LuisFran2611/PicoFFT/img/Esquematico_FM1.png

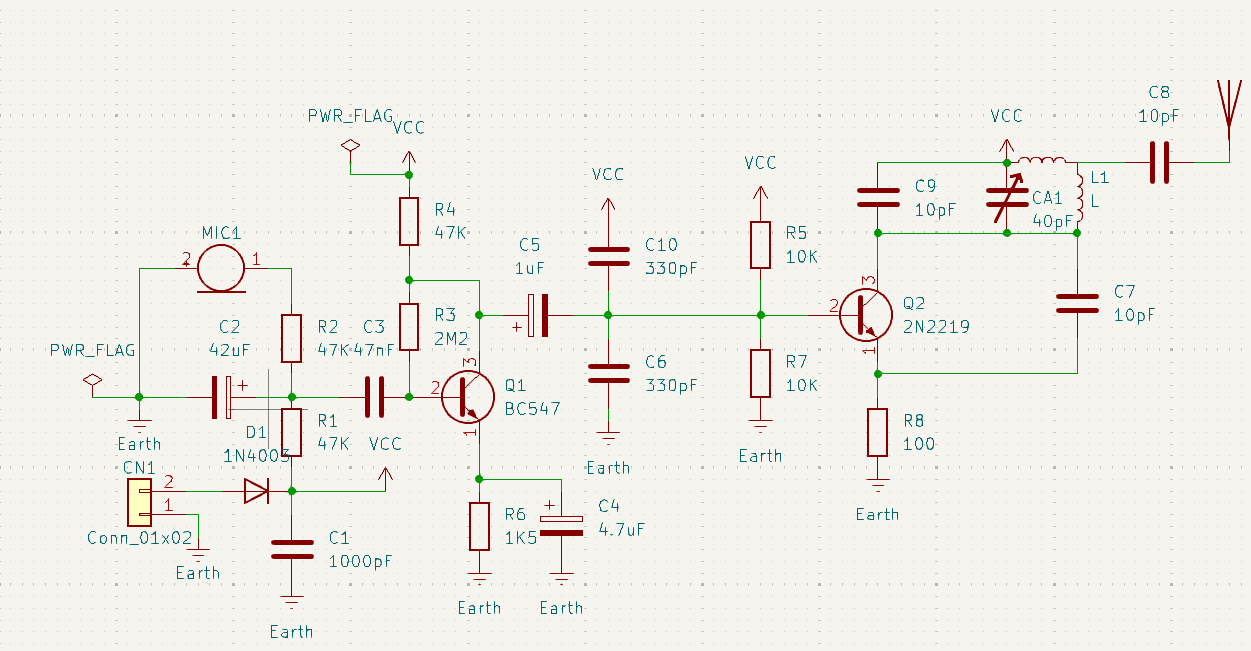
img/Esquematico_FM1.png
