LuisFran2611/PicoFFT/img/Radio.jpg

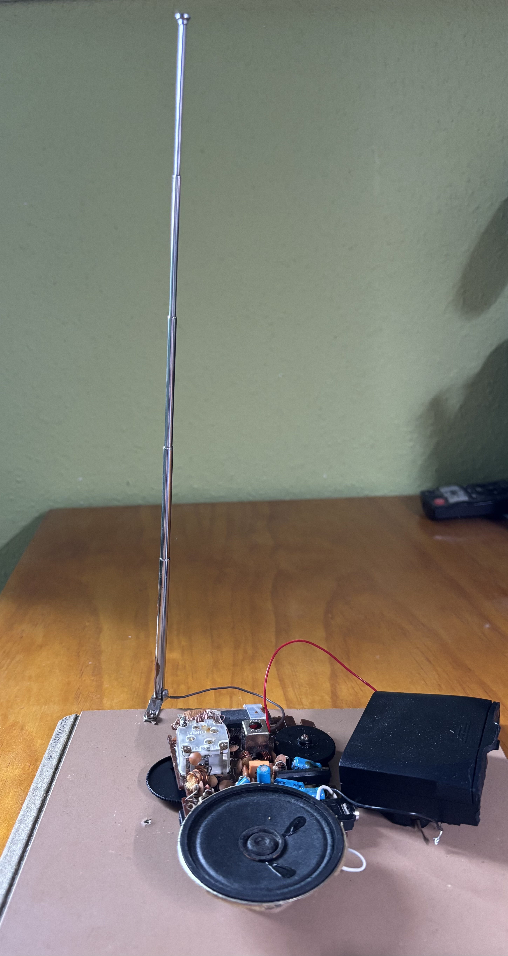
img/Radio.jpg
