LuisFran2611/PicoFFT/img/Prueba_display.JPG

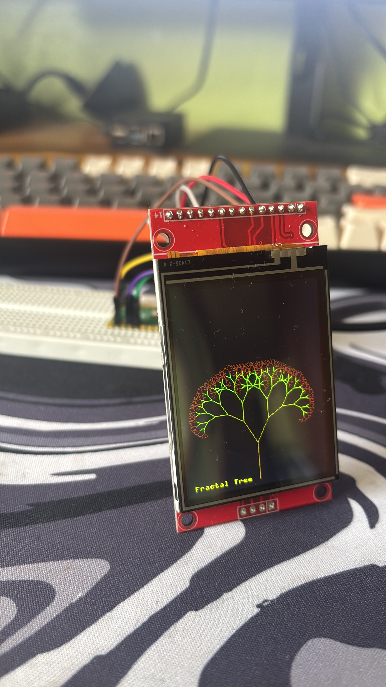
img/Prueba_display.JPG
